ese-519/Abdominal-Auditory-Monitor/images/1102_fft_graph.jpg

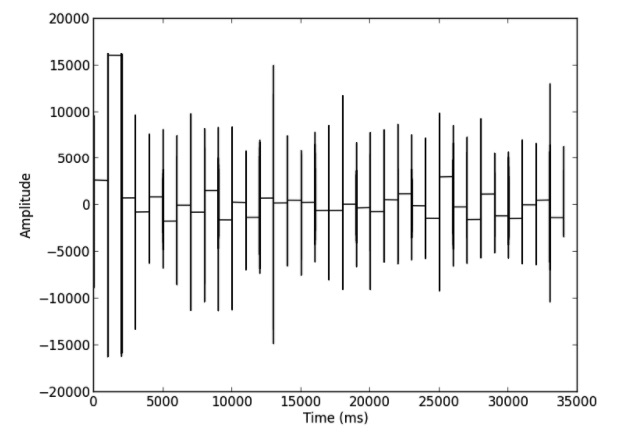
images/1102_fft_graph.jpg
