ese-519/Abdominal-Auditory-Monitor/images/1118_matlab_plot1.jpg

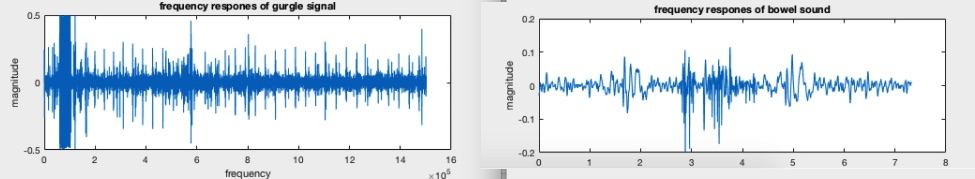
images/1118_matlab_plot1.jpg
