ese-519/Abdominal-Auditory-Monitor/images/1118_matlab_plot2.jpg

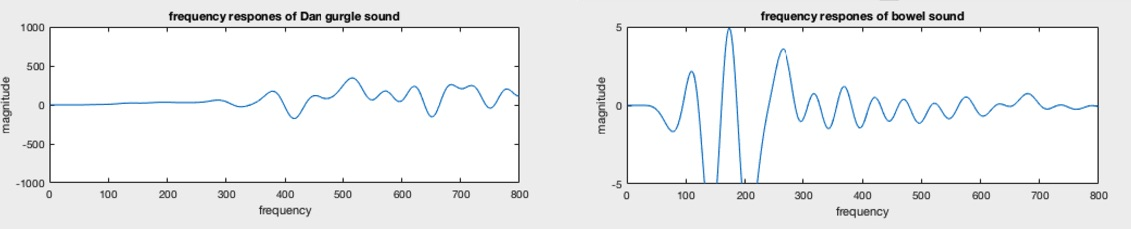
images/1118_matlab_plot2.jpg
