ese-519/Abdominal-Auditory-Monitor/images/1118_steth_board.JPG

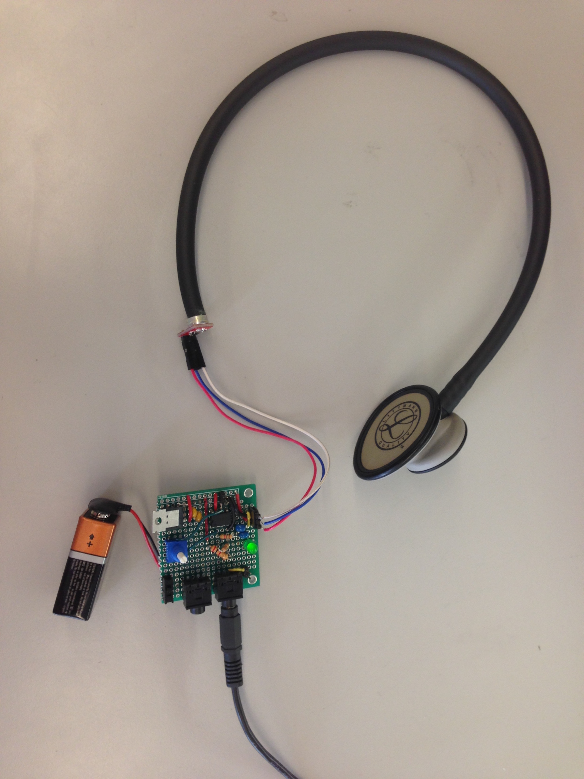
images/1118_steth_board.JPG
