ese-519/Abdominal-Auditory-Monitor/images/1128_bandage.JPG

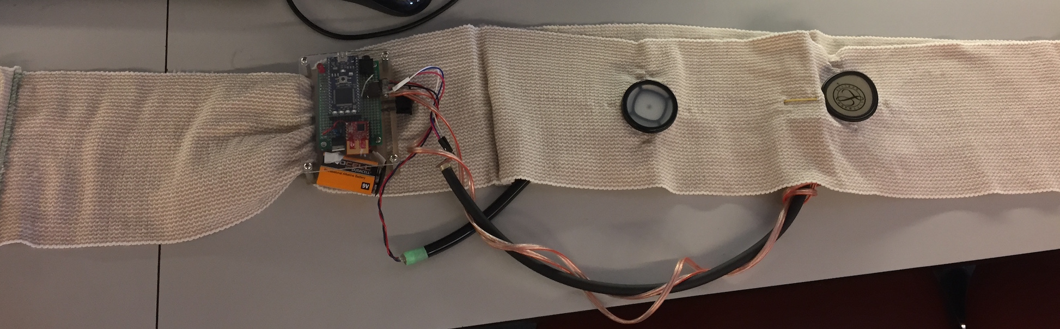
images/1128_bandage.JPG
