ese-519/Abdominal-Auditory-Monitor/images/1206_decision_tree.png

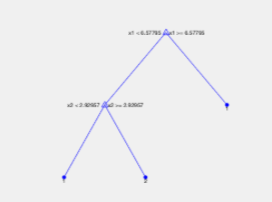
images/1206_decision_tree.png
