ese-519/Abdominal-Auditory-Monitor/images/disconnected.jpg

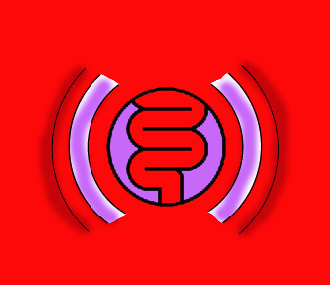
images/disconnected.jpg
