ese-519/Abdominal-Auditory-Monitor/images/eat.jpg

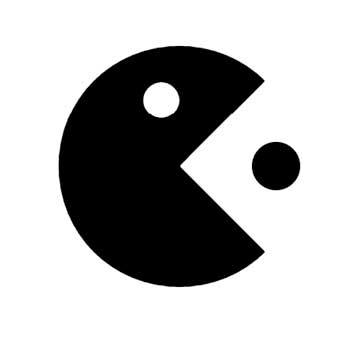
images/eat.jpg
