ese-519/Abdominal-Auditory-Monitor/images/ex_view.jpg

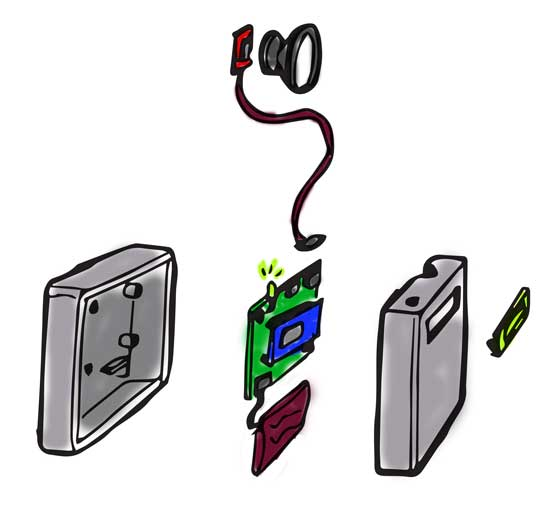
images/ex_view.jpg
