ese-519/Abdominal-Auditory-Monitor/images/label.jpg

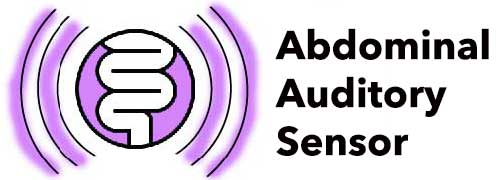
images/label.jpg
