ese-519/Abdominal-Auditory-Monitor/images/MicCircuit.PNG

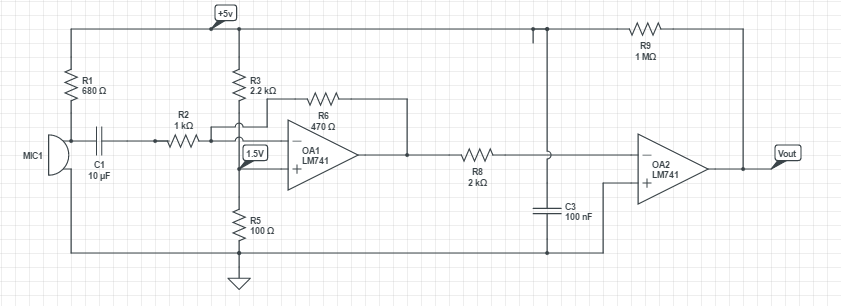
images/MicCircuit.PNG
