ese-519/Abdominal-Auditory-Monitor/images/no_eat.jpg

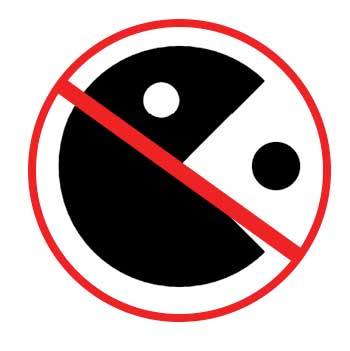
images/no_eat.jpg
