ese-519/Abdominal-Auditory-Monitor/images/sitting.jpg

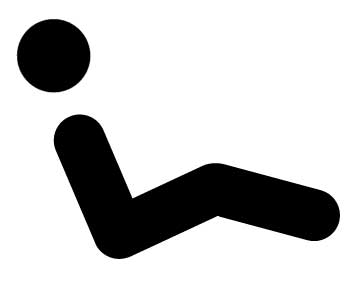
images/sitting.jpg
