ese-519/Abdominal-Auditory-Monitor/images/stetho.gif

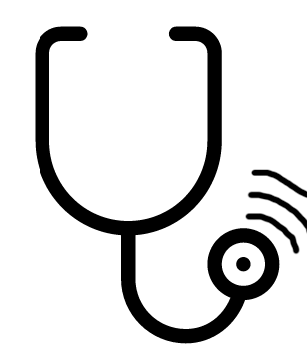
images/stetho.gif
