ese-519/Abdominal-Auditory-Monitor/images/walking.jpg

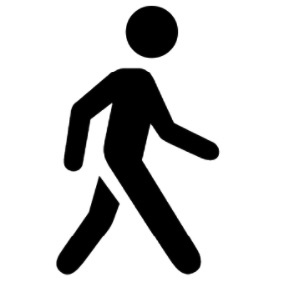
images/walking.jpg
